cskordis/VIPTape/README.md

# VIPTape

This project was created by Josh Bensadon that allows you to load and save code via the cassette port to and from the Cosmac VIP.

Version 1.1 only does VIP computers.

Version 2 and up, re-written to accomodate ELF II, HUG 1802/ETI-660/HEC-1802 and VIP computers.

Version 2o is only for the ORAO computer protocol.

Version 3 added ORAO computer protocol.

Version 4 added COMiX 35 protocol. Will load comx files that are Basic and Basic with machine code. It will not load all machine code.

Version 4a SD directories and files listed alphabetically

Version 4b added Heathkit ET 3400 protocol for machine code and basic
           Will load and save Basic as *.BAS and machine code as *.S19 format
           
Version 4c Added plain hex delimited by space file with extension *.txt for the ET3400

Version 5  Added TRS-80 Pocket Computer PC1 and PC2

Version 5a Corrected messaging when processing large programs. Renamed to VIPTAPE II

Version 5b Deletion of files when highlighted and No button pressed for > 1.2 seconds.

Version 5c Correct saving of last protocol to SD card.

Version 5d Update messaging to include filename.      

## Summary of prototols:
COMX35

Cosmac VIP and VIP-S

ELF II

Heathkit ET3400

HUG 1802/ETI-660/HEC-1802

Generic Kansas Citity Standard 300/1200

Orao

TRS-80 Pocket Computer PC1 and PC2

## Hardware modifications from original:

1. Enhance the LM358 op amp circuit to utilize the first op amp as a low pass filtering amp for >2500hz frequencies and second op amp as a comparator to deliver nicely formed square wares that are 3.5 v p/p.

2. Construction is straight forward but there is a minor cut to pins connecting D11, D12 and D13 from the VipTape shield (see image).
 

4. The input pin on the Mega was moved from A8 to D18 to allow correct ISR to work.

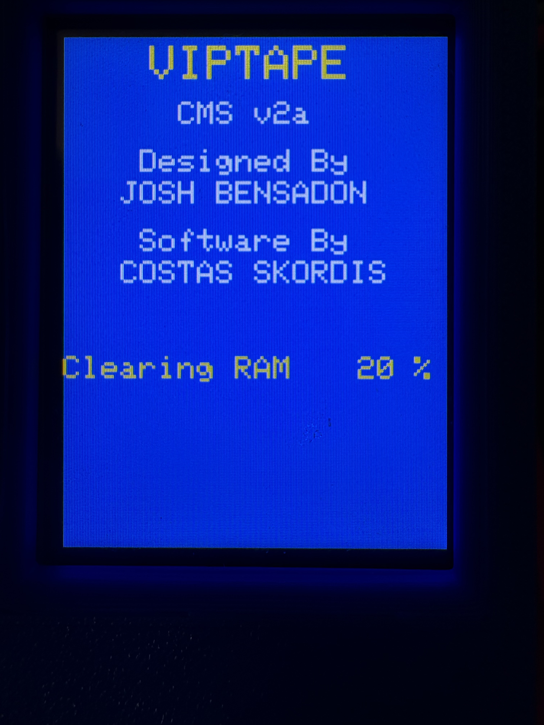
[picture p1: Images/TitleScreen.JPG]
VIPTape v2a Splash


VIPTape v2a

VIPTape v2a Keyboard Entry
