cskordis/VIPTape/Images/ReadyToPlay.JPG

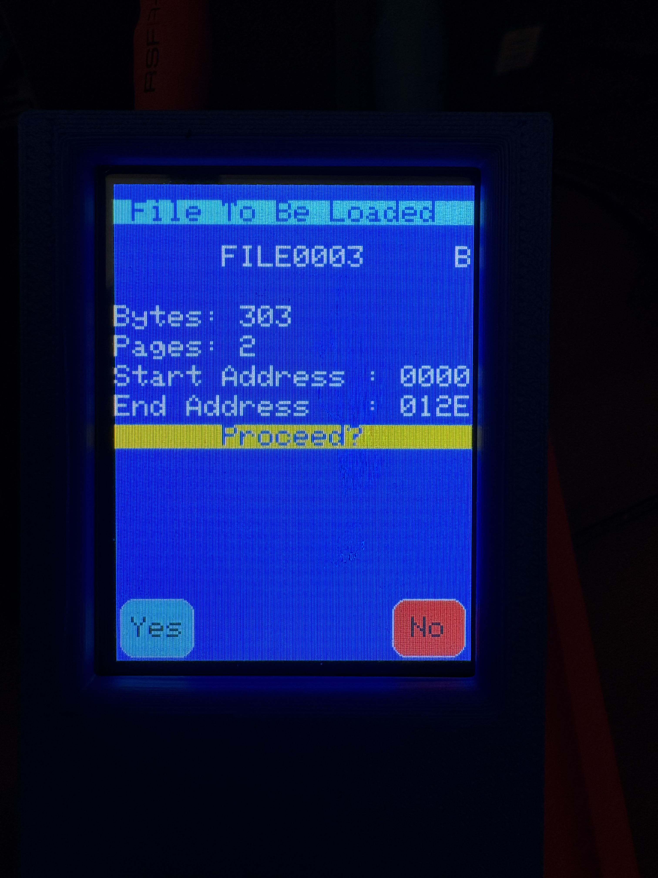
Images/ReadyToPlay.JPG
