cskordis/VIPTape/Images/ReadyToSavePrompt.JPG

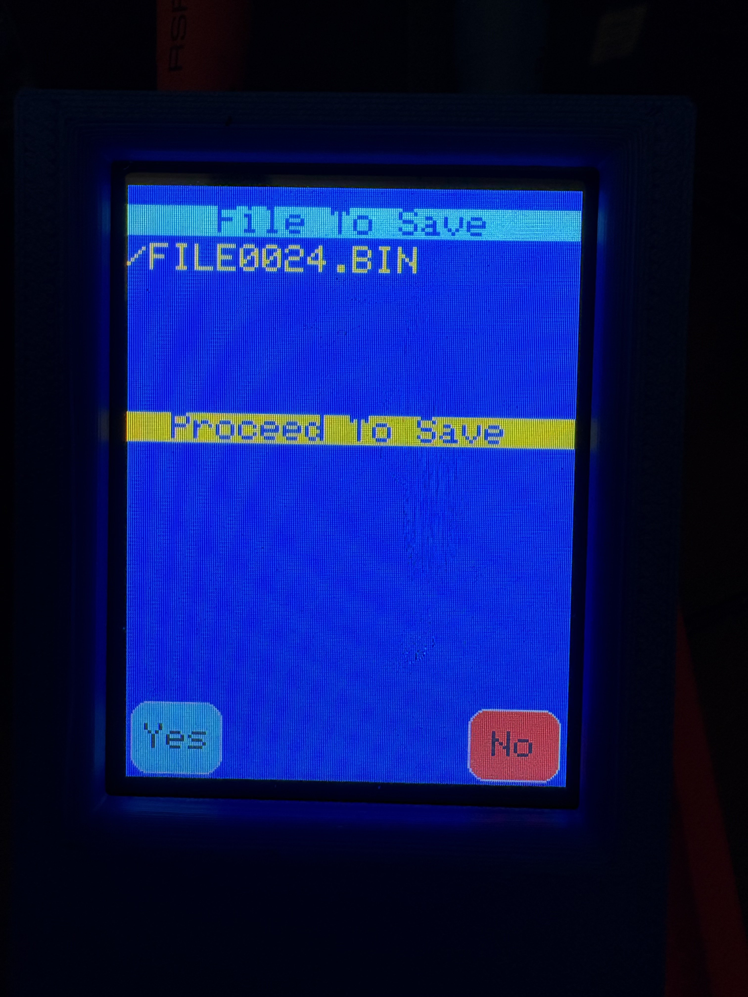
Images/ReadyToSavePrompt.JPG
