cskordis/VIPTape/Images/VIPTape.JPG

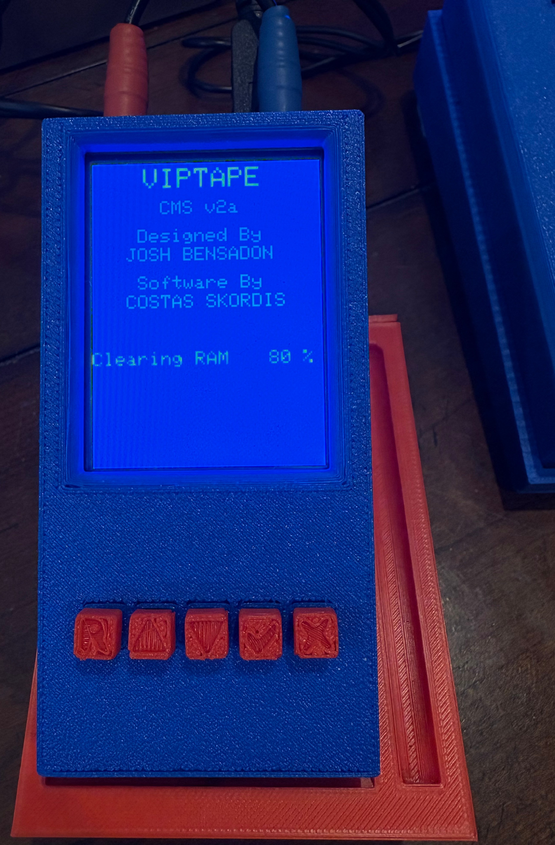
Images/VIPTape.JPG
