cskordis/VIPTape/Images/VIPTapeV2 Component Side.jpg

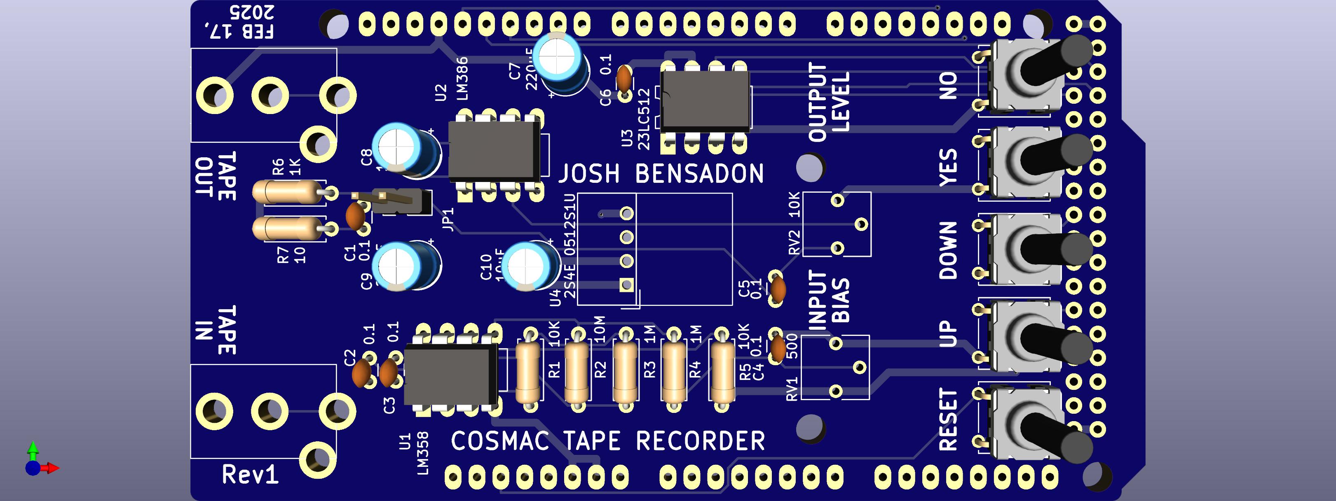
Images/VIPTapeV2 Component Side.jpg
