cskordis/VIPTape/Images/VIPTapeV2 Solder Side.jpg

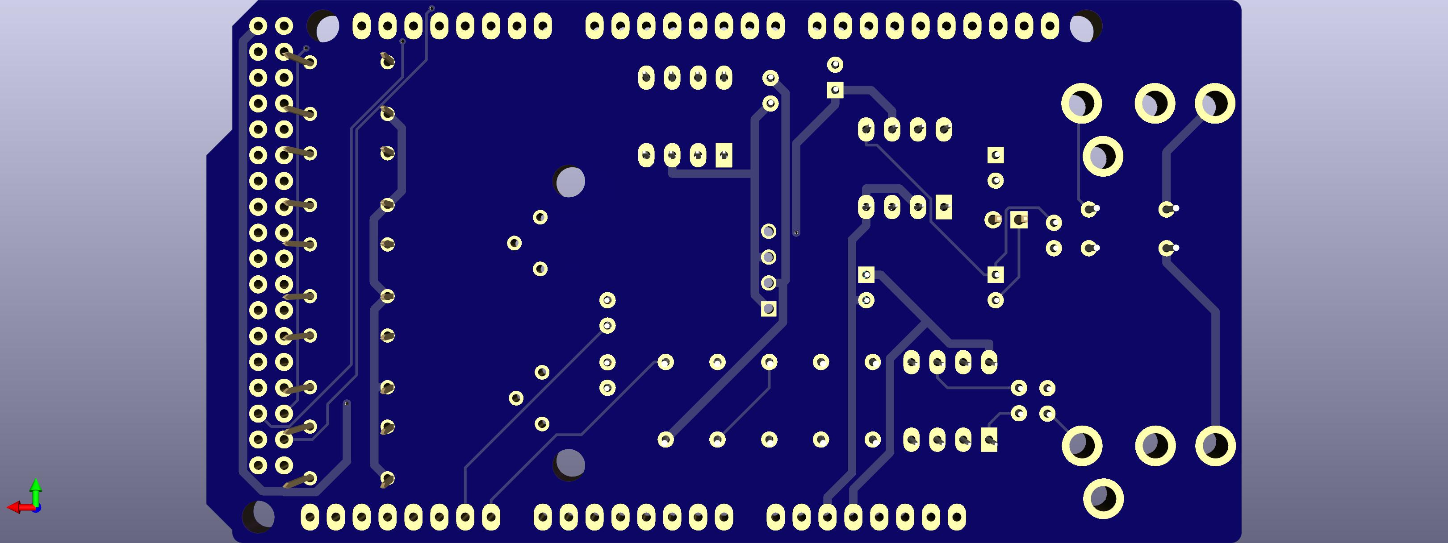
Images/VIPTapeV2 Solder Side.jpg
