cskordis/VIPTape/SD Card File/ETA3400/Test.txt

S113000000112233445566778899AABBCCDDEEFFF4
