cskordis/VIPTape/SD Card File/ELFII/Test.txt

90 B1 B2 8A F8 0F A2 F8 00 A1 7B 30 13 00 AA 51 11 81 FC 00 32 0C 30 0F
