cskordis/VIPTape/Schematic/VIPTapeV2a_Schematic.pdf

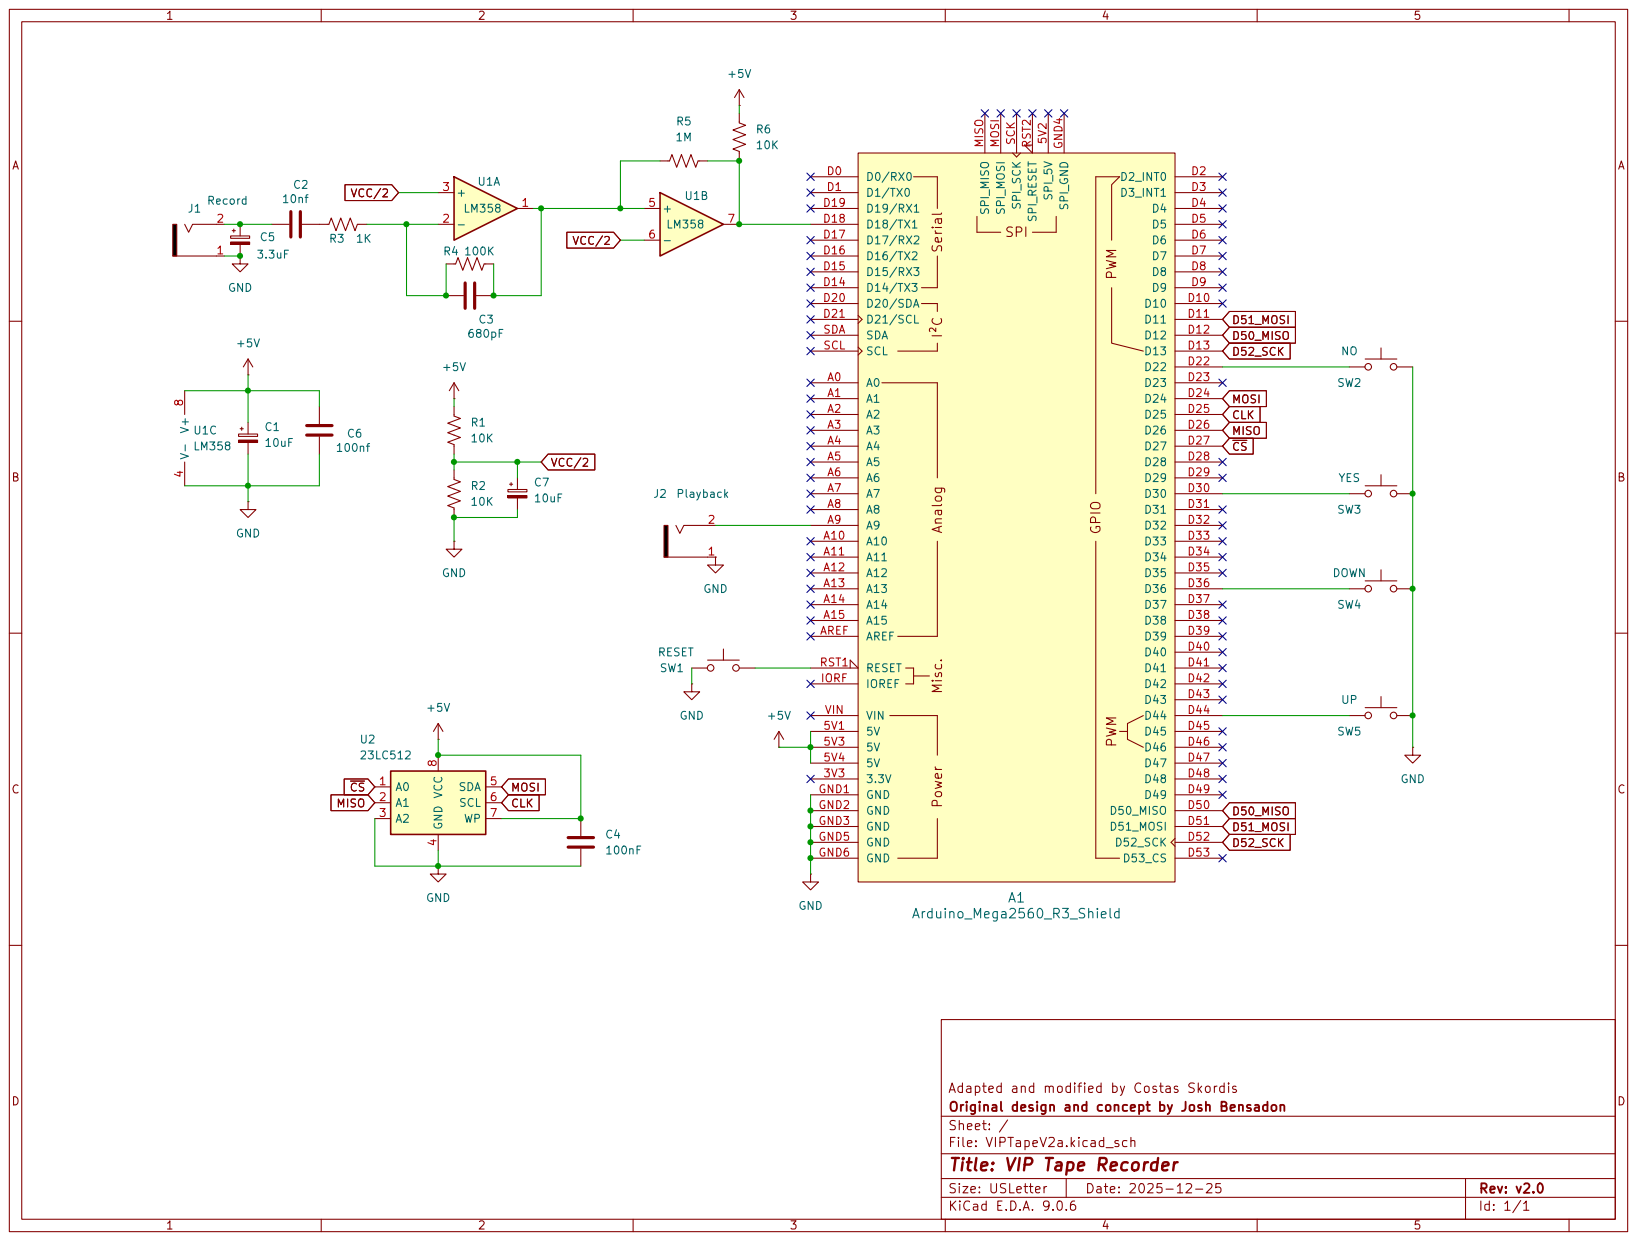
[picture p7: page 1]
