cskordis/VIPTape/Schematic/CosmacVIPTapeV2 Schematic.pdf

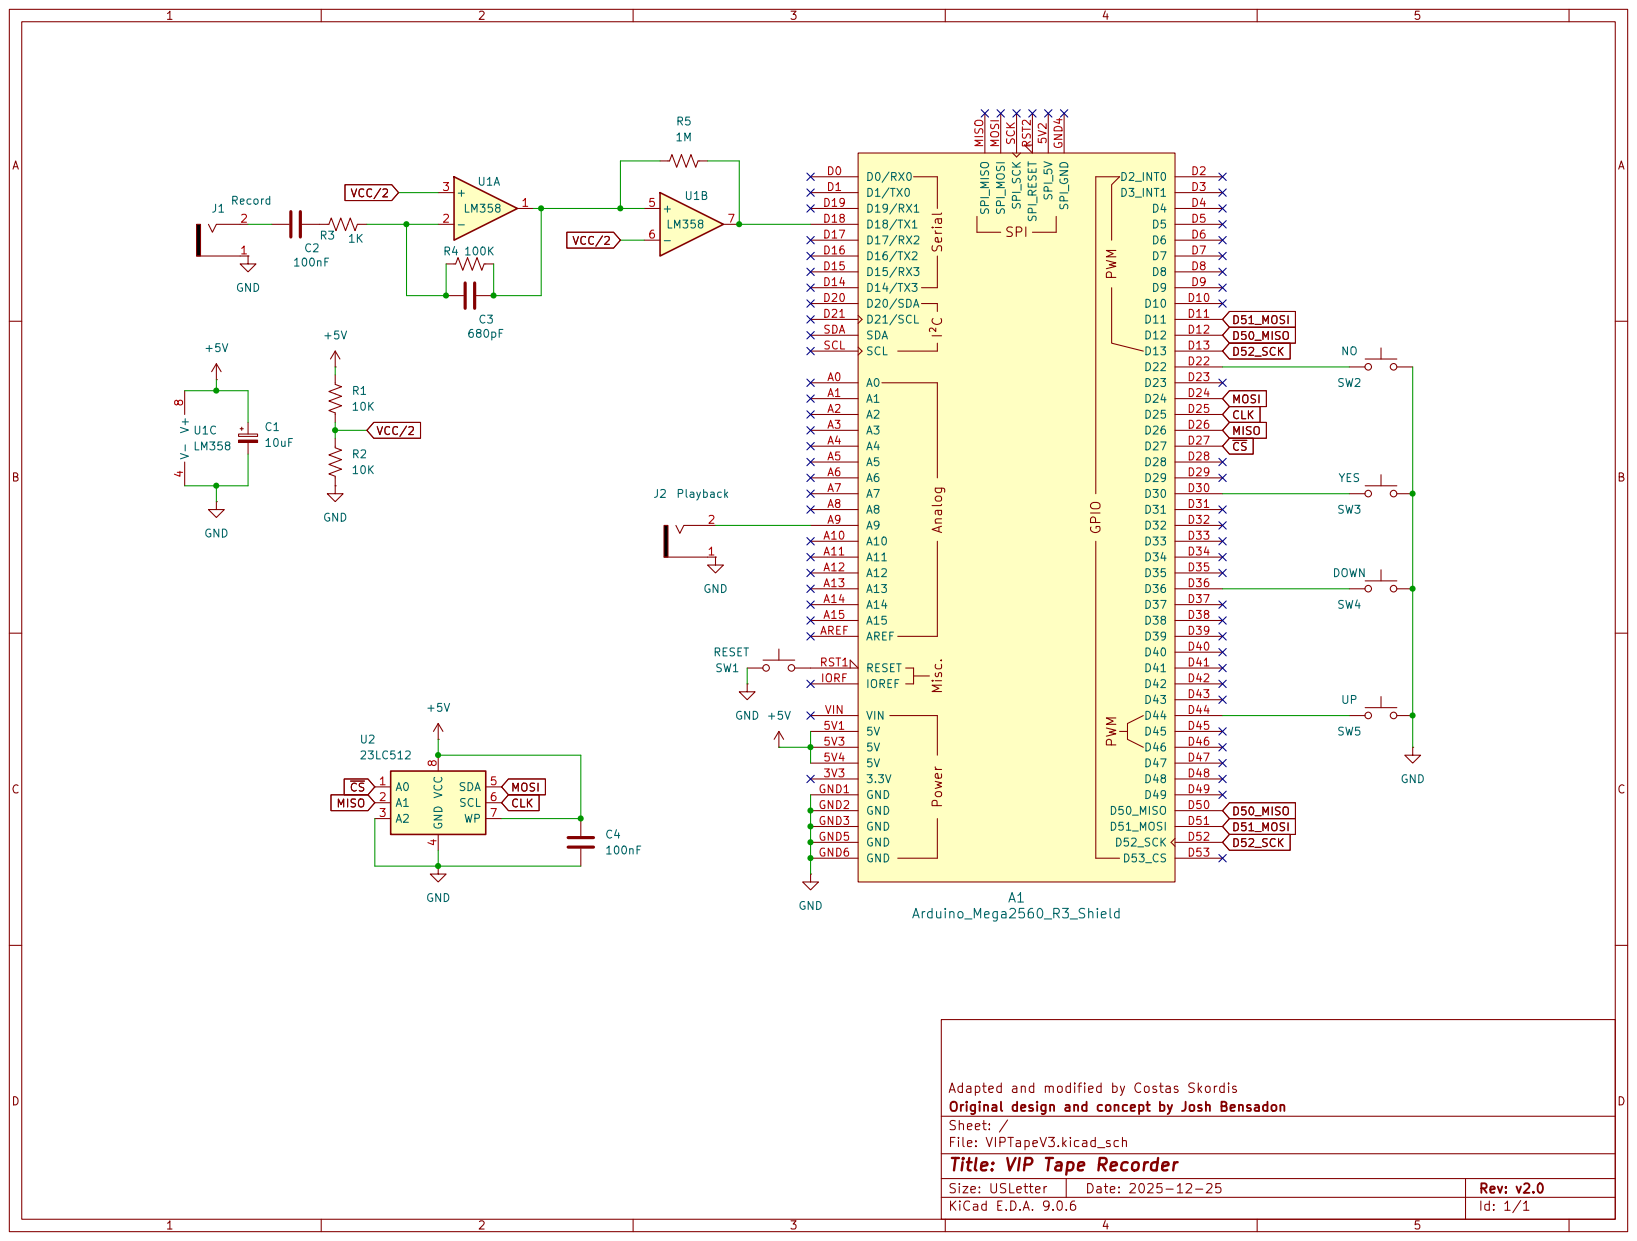
[picture p8: page 1]
