cskordis/VIPTape/Schematic/VIPTAPE - SCH.pdf

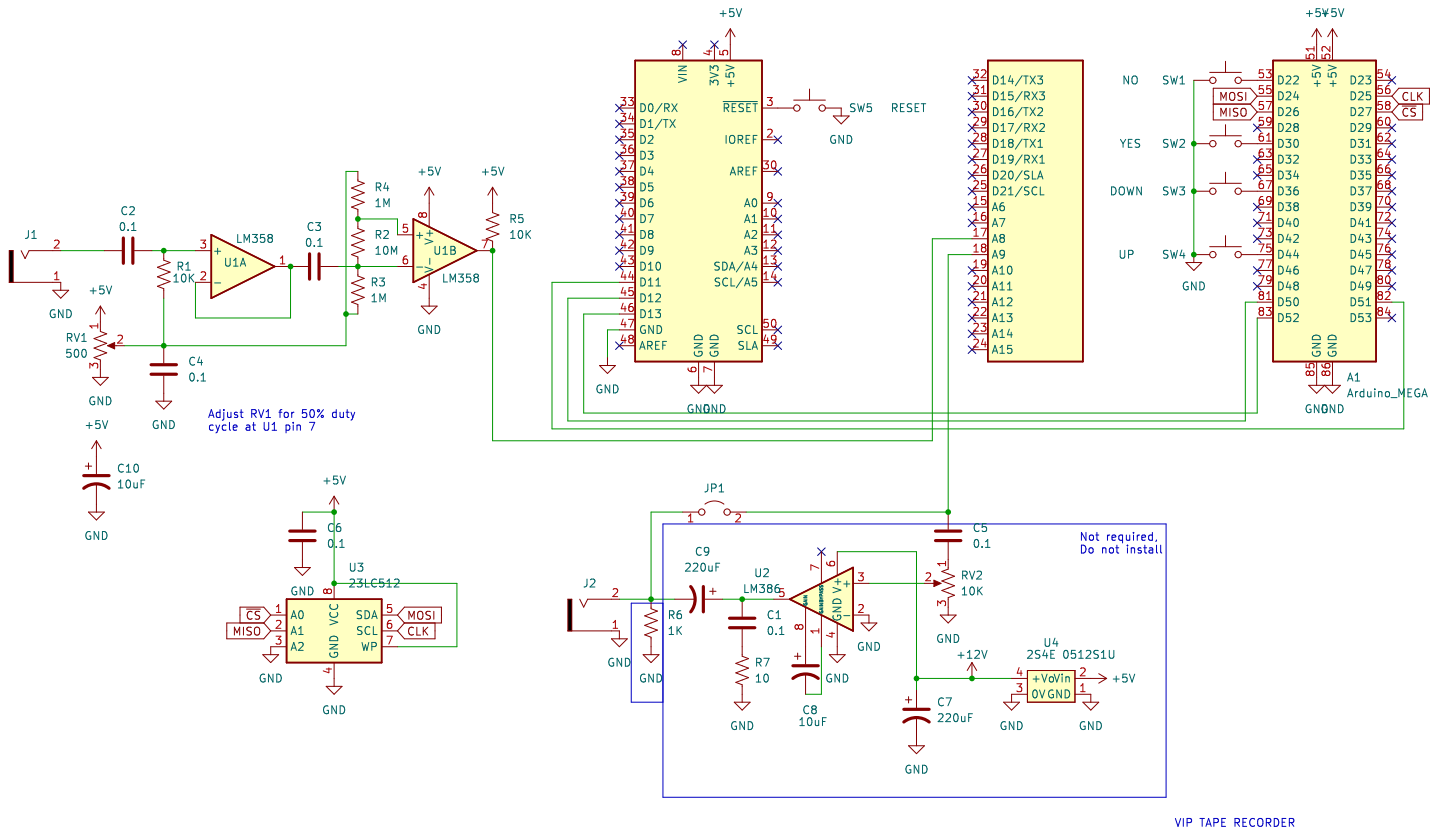
[picture p9: page 1]
