cskordis/VIPTape/(commit log)

2025-06-14 Create VIPTape-Gerbers.zip
    Gerber files for board manufacturing
2025-06-14 Create VIPTAPE - Gerbers.zip
    Build details
2025-06-14 Create VIPTAPE-Mega-Home-LT1.ino
    Arduino code
2025-06-14 Create VIPTAPE - SCH.pdf
    Schematic
2025-06-14 Add files via upload
    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
2025-06-14 Create VIPTAPE - PIC.jpg
    Board image
2025-06-14 Add files via upload
    Interactive BOM
2025-06-14 Add files via upload
    BOM Spreadsheet
    [VIPTape_BOM.csv]
2025-09-23 Add files via upload
    VIP Tape silkscreen update
2025-09-23 Images update for v2 silkscreen
2025-11-05 Fixed bug
    When using the physical button "Y" to select file to transfer, the software kept looping back prior to sending file.
2025-11-07 Update arduino code
2025-11-24 Updated with correct Gerber files
2025-12-19 Update arduino project with vip version 1.1
2026-01-12 update files
    [VIPTape_BOM.csv]
2026-01-12 Update BOM
2026-01-22 Update Gerbers
2026-06-13 Updated version 3 to 3a
    Added the ability to turn on serial debug by holding the Yes button while resetting or rebooting
2026-08-05 Add Version 4b details for Heathkit ET 3400 protocol
2026-08-05 Version 4b contains Heathkit ET3400 protocol
